kentdev/mMicroSD/schematic/v2.0/mMicroSD.pdf

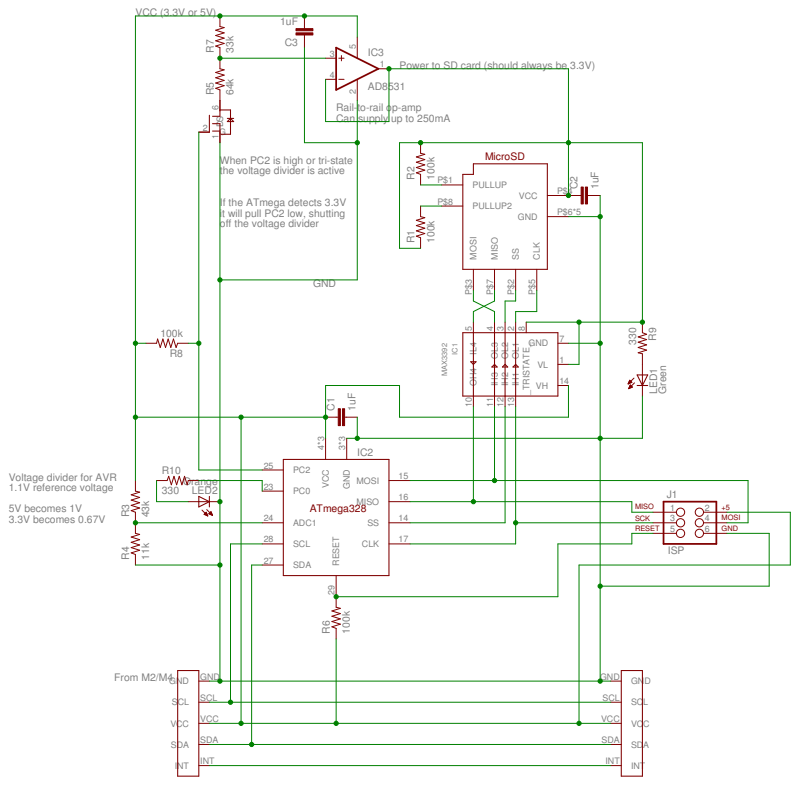
[picture p1: page 1]

Power to SD card (should always be 3.3V)
Rail-to-rail op-amp
Can supply up to 250mA

When PC2 is high or tri-state
the voltage divider is active

If the ATmega detects 3.3V
it will pull PC2 low, shutting
off the voltage divider

Voltage divider for AVR
1.1V reference voltage
5V becomes 1V
3.3V becomes 0.67V

VCC | | VCC

SDA | SDA
