kentdev/mMicroSD/schematic/v2.3/mMicroSD.brd

## EAGLE design schematic/v2.3/mMicroSD.brd (2015-05-24, an earlier design)

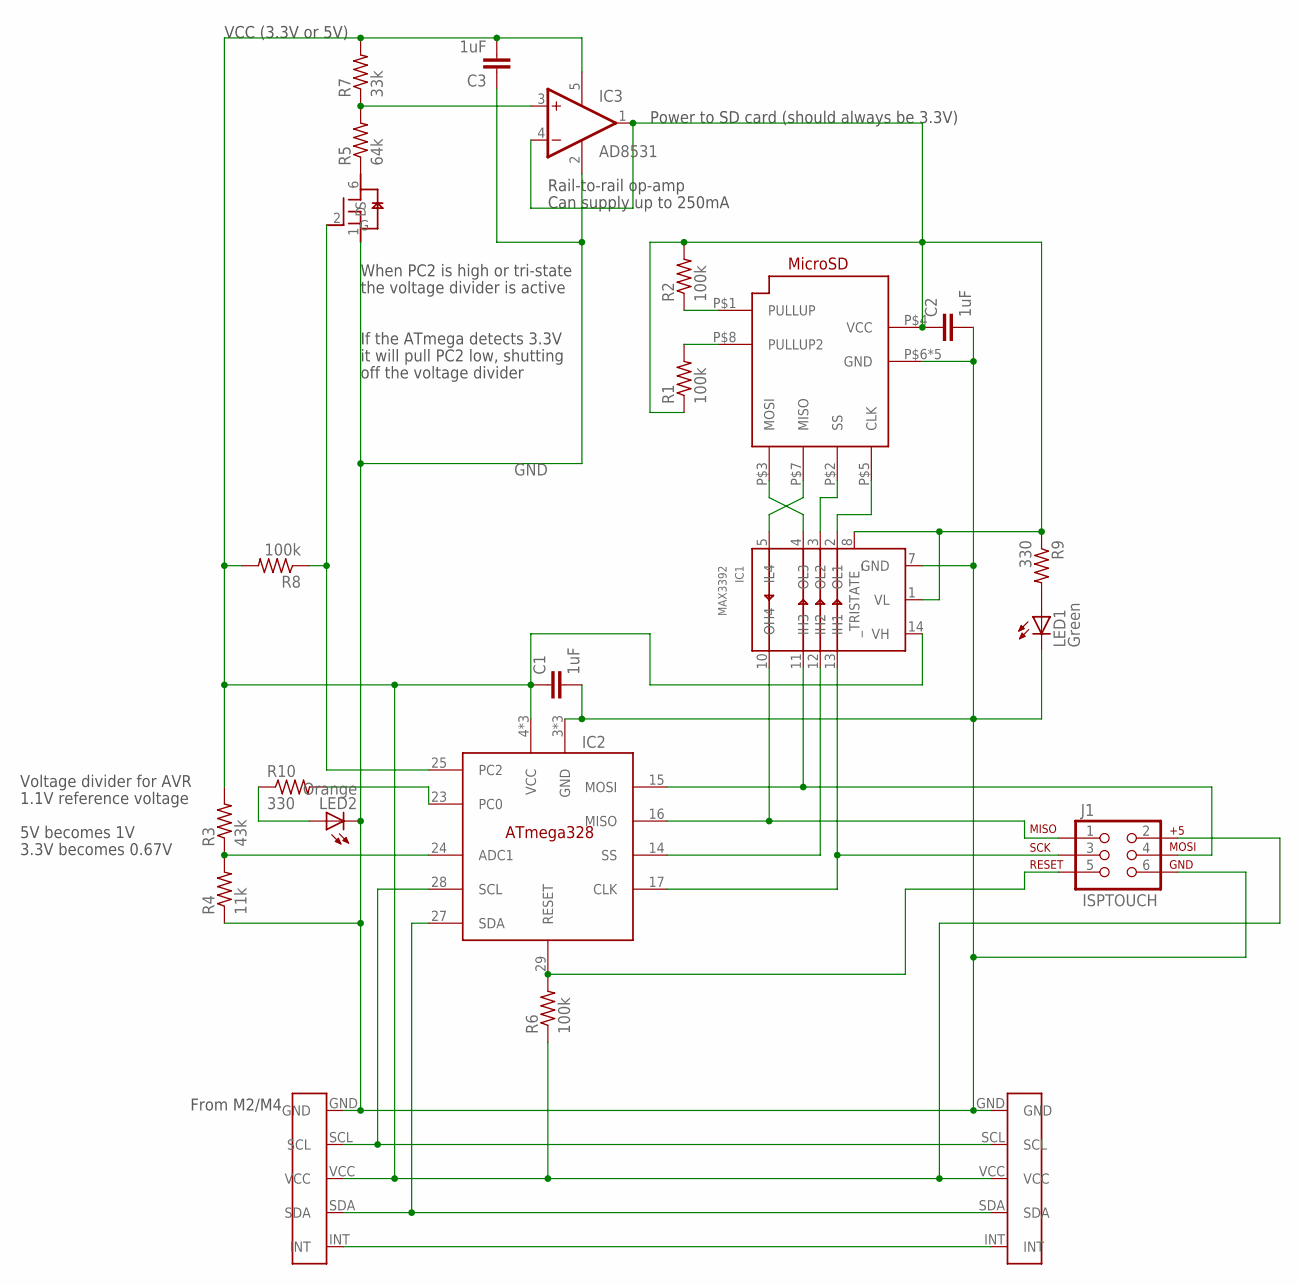
[picture p2: schematic mMicroSD.sch]

Parts:
C1, C2, C3: 1uF; C0603
IC1: MAX3392; 14-TSSOP
IC2: ATMEGA328
IC3: AD8531; SOT-23-5
J1: ISPTOUCH; AVX_9188_6-WAY_SMT
LED1: Green; SML0603
LED2: Orange; SML0603
M1: NTJD5121N; SOT-363
R1, R2, R6, R8: 100k; R0603
R3: 43k; R0603
R4: 11k; R0603
R5: 64k; R0603
R7: 33k; R0603
R9, R10: 330; R0603
SDCONN: 101-00660-68-6
U$1: MBUS_OUT
U$2: MBUS_IN

Connections:
ADC_LINE: IC2.24 (ADC1), R3.1, R4.2
DATA_LED: IC2.23 (PC0), R10.2
GATE: IC2.25 (PC2), M1.2 (G), R8.1
GND: C1.2, C2.2, C3.1, IC1.7 (GND), IC2.3 (GND), IC2.5 (GND), IC2.21 (GND), IC3.2 (V-), J1.6, LED1.C, LED2.C, M1.1 (S), R4.1, SDCONN.P$6 (GND), SDCONN.P$9 (GND), SDCONN.P$10 (GND), SDCONN.P$11 (GND), SDCONN.P$12 (GND), U$1.GND, U$2.GND
INT: U$1.INT, U$2.INT
MISO: IC1.10 (OH4), IC2.16 (MISO), J1.1
MOSI: IC1.11 (IH3), IC2.15 (MOSI), J1.4
unnamed: M1.6 (D), R5.1
unnamed: LED1.A, R9.2
unnamed: LED2.A, R10.1
unnamed: R1.2, SDCONN.P$8 (PULLUP2)
unnamed: R2.1, SDCONN.P$1 (PULLUP)
OPAMP_VOLTAGE: IC3.3 (+IN), R5.2, R7.1
RESET: IC2.29 (RESET), J1.5, R6.2
SCK: IC1.13 (IH1), IC2.17 (CLK), J1.3
SCL: IC2.28 (SCL), U$1.SCL, U$2.SCL
SDA: IC2.27 (SDA), U$1.SDA, U$2.SDA
SD_CS: IC1.3 (OL2), SDCONN.P$2 (SS)
SD_MISO: IC1.5 (IL4), SDCONN.P$7 (MISO)
SD_MOSI: IC1.4 (OL3), SDCONN.P$3 (MOSI)
SD_SCK: IC1.2 (OL1), SDCONN.P$5 (CLK)
SS: IC1.12 (IH2), IC2.14 (SS)
VCC_MBUS: C1.1, C3.2, IC1.14 (VH), IC2.4 (VCC), IC2.6 (VCC), IC2.18 (VCC), IC3.5 (V+), J1.2, R3.2, R6.1, R7.2, R8.2, U$1.VCC, U$2.VCC
VCC_SD: C2.1, IC1.1 (VL), IC1.8 (_TRISTATE_), IC3.1 (OUT), IC3.4 (-IN), R1.1, R2.2, R9.1, SDCONN.P$4 (VCC)

Notes on the sheet:
From M2/M4
VCC (3.3V or 5V)
Voltage divider for AVR
1.1V reference voltage
5V becomes 1V
3.3V becomes 0.67V
When PC2 is high or tri-state
the voltage divider is active
If the ATmega detects 3.3V
it will pull PC2 low, shutting
off the voltage divider
Power to SD card (should always be 3.3V)
Rail-to-rail op-amp
Can supply up to 250mA

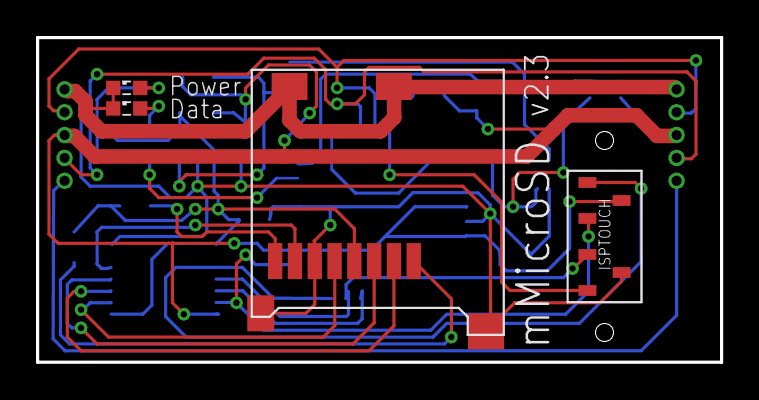
[picture p3: board schematic/v2.3/mMicroSD.brd from above]

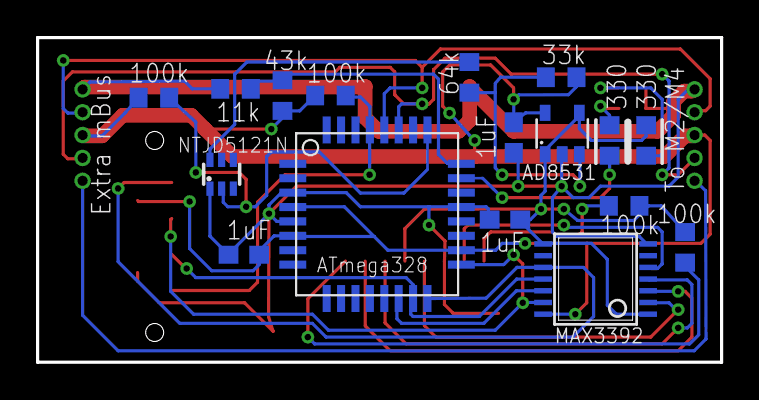
[picture p4: board schematic/v2.3/mMicroSD.brd from below]

Board: 2 copper layers, 38.0 x 18.0 mm, 23 parts (17 on the bottom side), 24 nets.
