kentdev/mMicroSD/schematic/v1.0/mMicroSD.brd

## EAGLE design schematic/v1.0/mMicroSD.brd (2014-10-27, an earlier design)

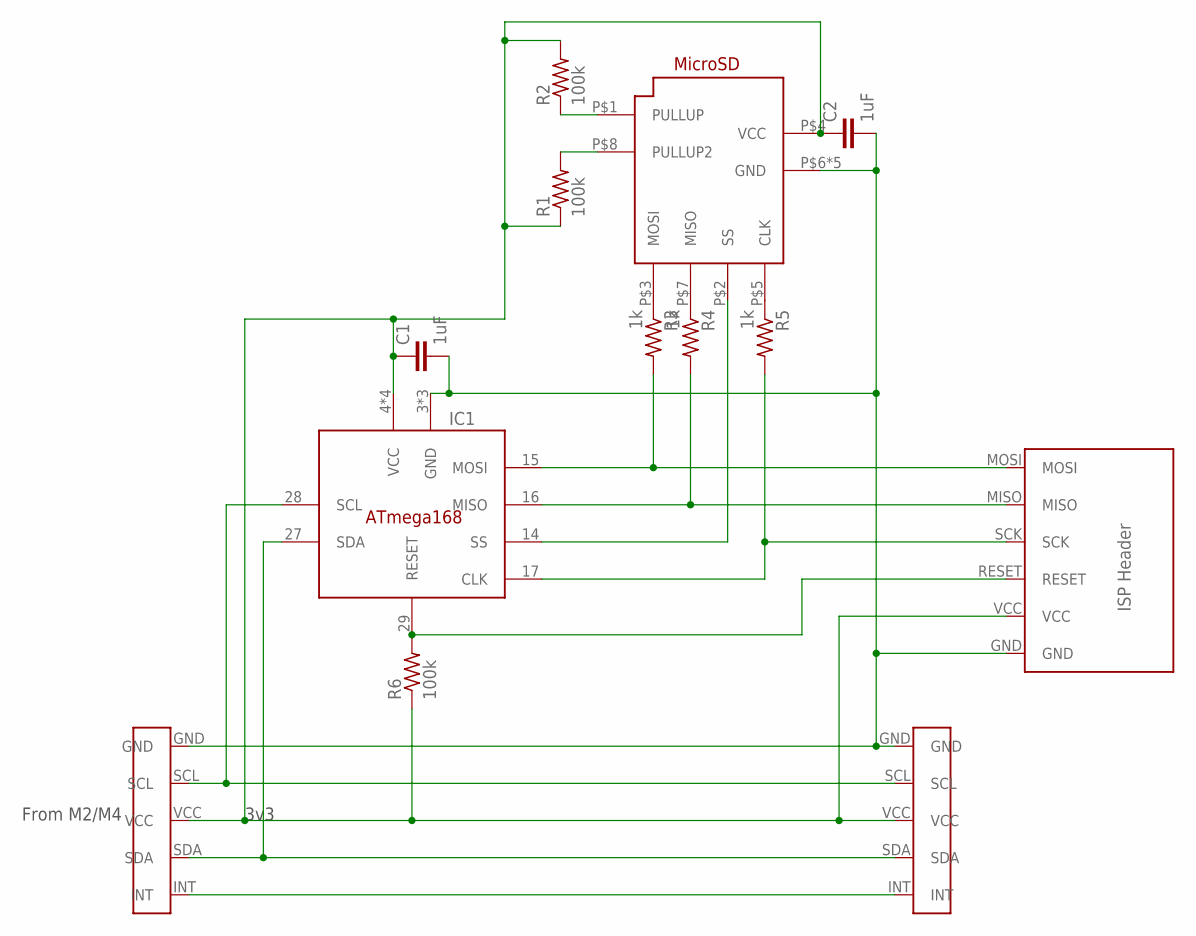
[picture p5: schematic mMicroSD.sch]

Parts:
C1, C2: 1uF; C0805
IC1: ATMEGA168
R1, R2, R6: 100k; R2012
R3, R4, R5: 1k; R2012
SDCONN: 101-00660-68-6
U$1: MBUS_OUT
U$2: MBUS_IN
U$3: ISP

Connections:
GND: C1.2, C2.2, IC1.3 (GND), IC1.5 (GND), IC1.21 (GND), SDCONN.P$6 (GND), SDCONN.P$9 (GND), SDCONN.P$10 (GND), SDCONN.P$11 (GND), SDCONN.P$12 (GND), U$1.GND, U$2.GND, U$3.GND
unnamed: U$1.INT, U$2.INT
unnamed: IC1.27 (SDA), U$1.SDA, U$2.SDA
unnamed: IC1.28 (SCL), U$1.SCL, U$2.SCL
unnamed: IC1.14 (SS), SDCONN.P$2 (SS)
unnamed: R3.1, SDCONN.P$3 (MOSI)
unnamed: R4.1, SDCONN.P$7 (MISO)
unnamed: IC1.16 (MISO), R4.2, U$3.MISO
unnamed: IC1.15 (MOSI), R3.2, U$3.MOSI
unnamed: IC1.29 (RESET), R6.2, U$3.RESET
unnamed: R1.2, SDCONN.P$8 (PULLUP2)
unnamed: R2.1, SDCONN.P$1 (PULLUP)
unnamed: IC1.17 (CLK), R5.2, U$3.SCK
unnamed: R5.1, SDCONN.P$5 (CLK)
VCC: C1.1, C2.1, IC1.4 (VCC), IC1.6 (VCC), IC1.18 (VCC), IC1.20 (VCC), R1.1, R2.2, R6.1, SDCONN.P$4 (VCC), U$1.VCC, U$2.VCC, U$3.VCC

Notes on the sheet:
3v3
From M2/M4

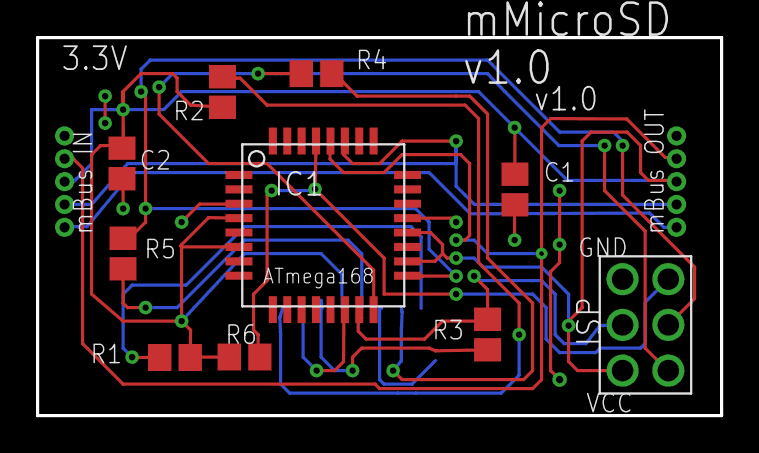
[picture p6: board schematic/v1.0/mMicroSD.brd from above]

Board: 2 copper layers, 38.0 x 21.0 mm, 13 parts (1 on the bottom side), 15 nets.
