kentdev/mMicroSD/code/m4_direct/mUSB.c

//-----------------------------------------------------------------------------
// MAEVARM M4 STM32F373 mUSB
// version: 1.0
// date: March 22, 2013
// author: Neel Shah (neels@seas.upenn.edu)
// Based on ST USB FS Driver LIbrary Example Virtual COM Port
//-----------------------------------------------------------------------------

#include "mUSB.h"

#define VCOMPORT_IN_FRAME_INTERVAL             5

__IO uint32_t bDeviceState = UNCONNECTED; /* USB device status */
__IO bool fSuspendEnabled = FALSE;  /* true when suspend is possible */
__IO uint32_t EP[8];
struct
{
  __IO RESUME_STATE eState;
  __IO uint8_t bESOFcnt;
}
ResumeS;
__IO uint32_t remotewakeupon=0;


__IO uint16_t wIstr;  /* ISTR register last read value */
__IO uint8_t bIntPackSOF = 0;  /* SOFs received between 2 consecutive packets */
__IO uint32_t esof_counter =0; /* expected SOF counter */
__IO uint32_t wCNTR=0;
ErrorStatus HSEStartUpStatus;
EXTI_InitTypeDef EXTI_InitStructure;
__IO uint8_t Send_Buffer[VIRTUAL_COM_PORT_DATA_SIZE] ;
uint32_t Receive_length;

extern __IO uint32_t packet_sent;
extern __IO uint32_t packet_receive;


uint8_t Request = 0;

LINE_CODING linecoding =
  {
    115200, /* baud rate*/
    0x00,   /* stop bits-1*/
    0x00,   /* parity - none*/
    0x08    /* no. of bits 8*/
  };

uint8_t Receive_Buffer[64];
uint32_t Send_length;



/*=========== Minimal System Call Implementation for newlib ===========*/

__IO uint32_t packet_sent=1;
__IO uint32_t packet_receive ;
char *__env[1] = { 0 };
char **environ = __env;

int _write(int file, char *ptr, int len)
{
  if(bDeviceState == CONFIGURED)
  {
    uint32_t timeout=180000;
    while((!packet_sent) && timeout--){}
    if(timeout)
    {
      uint8_t packetNo,finalPacket,i;
      packetNo    = len/64;
      finalPacket = len;
      for(i=0;i<packetNo;i++)
      {
        CDC_Send_DATA(ptr,63);
        finalPacket -= 63;
        ptr += 63;
        timeout=180000;
        while(packet_sent==0 && timeout--);
        if(timeout==0)
        { 
          bDeviceState = UNCONNECTED;
          return len;
        }
      }
      CDC_Send_DATA(ptr,finalPacket);
      return len;  
    }
    else 
    {
      return -1;
    }
  }
  else
  {
    return len;
  }

}


caddr_t _sbrk(int incr) 
{
  extern char _end; // Defined by the linker
  static char *heap_end;
  char *prev_heap_end;
  if(heap_end == 0) {heap_end = &_end;}
  prev_heap_end = heap_end;
  char * stack = (char*) __get_MSP();
  if (heap_end+incr >  stack)
    {
      _write(1, "Heap and stack collision\n", 25);
      return  (caddr_t) -1;
    }
  heap_end += incr;
  return (caddr_t) prev_heap_end;
}
int _read(int file, __IO char *ptr, int len) 
{
  CDC_Receive_DATA();
  ptr = Receive_Buffer;
  len = Receive_length;
  return len;
}
int _close(int file){return -1;}
int _fstat(int file, struct stat *st) {return 0;}
int _isatty(int file){return 1;}
int _lseek(int file, int ptr, int dir){return 0;}



/* USB Standard Device Descriptor */
const uint8_t Virtual_Com_Port_DeviceDescriptor[] =
  {
    0x12,   /* bLength */
    USB_DEVICE_DESCRIPTOR_TYPE,     /* bDescriptorType */
    0x00,
    0x02,   /* bcdUSB = 2.00 */
    0x02,   /* bDeviceClass: CDC */
    0x00,   /* bDeviceSubClass */
    0x00,   /* bDeviceProtocol */
    0x40,   /* bMaxPacketSize0 */
    0x83,
    0x04,   /* idVendor = 0x0483 */
    0x40,
    0x57,   /* idProduct = 0x7540 */
    0x00,
    0x02,   /* bcdDevice = 2.00 */
    1,              /* Index of string descriptor describing manufacturer */
    2,              /* Index of string descriptor describing product */
    3,              /* Index of string descriptor describing the device's serial number */
    0x01    /* bNumConfigurations */
  };

const uint8_t Virtual_Com_Port_ConfigDescriptor[] =
  {
    /*Configuration Descriptor*/
    0x09,   /* bLength: Configuration Descriptor size */
    USB_CONFIGURATION_DESCRIPTOR_TYPE,      /* bDescriptorType: Configuration */
    VIRTUAL_COM_PORT_SIZ_CONFIG_DESC,       /* wTotalLength:no of returned bytes */
    0x00,
    0x02,   /* bNumInterfaces: 2 interface */
    0x01,   /* bConfigurationValue: Configuration value */
    0x00,   /* iConfiguration: Index of string descriptor describing the configuration */
    0xC0,   /* bmAttributes: self powered */
    0x32,   /* MaxPower 0 mA */
    /*Interface Descriptor*/
    0x09,   /* bLength: Interface Descriptor size */
    USB_INTERFACE_DESCRIPTOR_TYPE,  /* bDescriptorType: Interface */
    /* Interface descriptor type */
    0x00,   /* bInterfaceNumber: Number of Interface */
    0x00,   /* bAlternateSetting: Alternate setting */
    0x01,   /* bNumEndpoints: One endpoints used */
    0x02,   /* bInterfaceClass: Communication Interface Class */
    0x02,   /* bInterfaceSubClass: Abstract Control Model */
    0x01,   /* bInterfaceProtocol: Common AT commands */
    0x00,   /* iInterface: */
    /*Header Functional Descriptor*/
    0x05,   /* bLength: Endpoint Descriptor size */
    0x24,   /* bDescriptorType: CS_INTERFACE */
    0x00,   /* bDescriptorSubtype: Header Func Desc */
    0x10,   /* bcdCDC: spec release number */
    0x01,
    /*Call Management Functional Descriptor*/
    0x05,   /* bFunctionLength */
    0x24,   /* bDescriptorType: CS_INTERFACE */
    0x01,   /* bDescriptorSubtype: Call Management Func Desc */
    0x00,   /* bmCapabilities: D0+D1 */
    0x01,   /* bDataInterface: 1 */
    /*ACM Functional Descriptor*/
    0x04,   /* bFunctionLength */
    0x24,   /* bDescriptorType: CS_INTERFACE */
    0x02,   /* bDescriptorSubtype: Abstract Control Management desc */
    0x02,   /* bmCapabilities */
    /*Union Functional Descriptor*/
    0x05,   /* bFunctionLength */
    0x24,   /* bDescriptorType: CS_INTERFACE */
    0x06,   /* bDescriptorSubtype: Union func desc */
    0x00,   /* bMasterInterface: Communication class interface */
    0x01,   /* bSlaveInterface0: Data Class Interface */
    /*Endpoint 2 Descriptor*/
    0x07,   /* bLength: Endpoint Descriptor size */
    USB_ENDPOINT_DESCRIPTOR_TYPE,   /* bDescriptorType: Endpoint */
    0x82,   /* bEndpointAddress: (IN2) */
    0x03,   /* bmAttributes: Interrupt */
    VIRTUAL_COM_PORT_INT_SIZE,      /* wMaxPacketSize: */
    0x00,
    0xFF,   /* bInterval: */
    /*Data class interface descriptor*/
    0x09,   /* bLength: Endpoint Descriptor size */
    USB_INTERFACE_DESCRIPTOR_TYPE,  /* bDescriptorType: */
    0x01,   /* bInterfaceNumber: Number of Interface */
    0x00,   /* bAlternateSetting: Alternate setting */
    0x02,   /* bNumEndpoints: Two endpoints used */
    0x0A,   /* bInterfaceClass: CDC */
    0x00,   /* bInterfaceSubClass: */
    0x00,   /* bInterfaceProtocol: */
    0x00,   /* iInterface: */
    /*Endpoint 3 Descriptor*/
    0x07,   /* bLength: Endpoint Descriptor size */
    USB_ENDPOINT_DESCRIPTOR_TYPE,   /* bDescriptorType: Endpoint */
    0x03,   /* bEndpointAddress: (OUT3) */
    0x02,   /* bmAttributes: Bulk */
    VIRTUAL_COM_PORT_DATA_SIZE,             /* wMaxPacketSize: */
    0x00,
    0x00,   /* bInterval: ignore for Bulk transfer */
    /*Endpoint 1 Descriptor*/
    0x07,   /* bLength: Endpoint Descriptor size */
    USB_ENDPOINT_DESCRIPTOR_TYPE,   /* bDescriptorType: Endpoint */
    0x81,   /* bEndpointAddress: (IN1) */
    0x02,   /* bmAttributes: Bulk */
    VIRTUAL_COM_PORT_DATA_SIZE,             /* wMaxPacketSize: */
    0x00,
    0x00    /* bInterval */
  };

/* USB String Descriptors */
const uint8_t Virtual_Com_Port_StringLangID[VIRTUAL_COM_PORT_SIZ_STRING_LANGID] =
  {
    VIRTUAL_COM_PORT_SIZ_STRING_LANGID,
    USB_STRING_DESCRIPTOR_TYPE,
    0x09,
    0x04 /* LangID = 0x0409: U.S. English */
  };

const uint8_t Virtual_Com_Port_StringVendor[VIRTUAL_COM_PORT_SIZ_STRING_VENDOR] =
  {
    VIRTUAL_COM_PORT_SIZ_STRING_VENDOR,     /* Size of Vendor string */
    USB_STRING_DESCRIPTOR_TYPE,             /* bDescriptorType*/
    /* Manufacturer: "STMicroelectronics" */
    'S', 0, 'T', 0, 'M', 0, 'i', 0, 'c', 0, 'r', 0, 'o', 0, 'e', 0,
    'l', 0, 'e', 0, 'c', 0, 't', 0, 'r', 0, 'o', 0, 'n', 0, 'i', 0,
    'c', 0, 's', 0
  };

const uint8_t Virtual_Com_Port_StringProduct[VIRTUAL_COM_PORT_SIZ_STRING_PRODUCT] =
  {
    VIRTUAL_COM_PORT_SIZ_STRING_PRODUCT,          /* bLength */
    USB_STRING_DESCRIPTOR_TYPE,        /* bDescriptorType */
    /* Product name: "STM32 Virtual COM Port" */
    'S', 0, 'T', 0, 'M', 0, '3', 0, '2', 0, ' ', 0, 'V', 0, 'i', 0,
    'r', 0, 't', 0, 'u', 0, 'a', 0, 'l', 0, ' ', 0, 'C', 0, 'O', 0,
    'M', 0, ' ', 0, 'P', 0, 'o', 0, 'r', 0, 't', 0, ' ', 0, ' ', 0
  };

uint8_t Virtual_Com_Port_StringSerial[VIRTUAL_COM_PORT_SIZ_STRING_SERIAL] =
  {
    VIRTUAL_COM_PORT_SIZ_STRING_SERIAL,           /* bLength */
    USB_STRING_DESCRIPTOR_TYPE,                   /* bDescriptorType */
    'S', 0, 'T', 0, 'M', 0, '3', 0, '2', 0
  };

RESULT PowerOn(void)
{
  uint16_t wRegVal;

  /*** cable plugged-in ? ***/
  USB_Cable_Config(ENABLE);

  /*** CNTR_PWDN = 0 ***/
  wRegVal = CNTR_FRES;
  _SetCNTR(wRegVal);

  /*** CNTR_FRES = 0 ***/
  wInterrupt_Mask = 0;
  _SetCNTR(wInterrupt_Mask);
  /*** Clear pending interrupts ***/
  _SetISTR(0);
  /*** Set interrupt mask ***/
  wInterrupt_Mask = CNTR_RESETM | CNTR_SUSPM | CNTR_WKUPM;
  _SetCNTR(wInterrupt_Mask);
  
  return USB_SUCCESS;
}
RESULT PowerOff()
{
  /* disable all interrupts and force USB reset */
  _SetCNTR(CNTR_FRES);
  /* clear interrupt status register */
  _SetISTR(0);
  /* Disable the Pull-Up*/
  USB_Cable_Config(DISABLE);
  /* switch-off device */
  _SetCNTR(CNTR_FRES + CNTR_PDWN);
  /* sw variables reset */
  /* ... */

  return USB_SUCCESS;
}
void Suspend(void)
{
	uint32_t i =0;
	uint16_t wCNTR;
	uint32_t tmpreg = 0;
  __IO uint32_t savePWR_CR=0;
	/* suspend preparation */
	/* ... */
	
	/*Store CNTR value */
	wCNTR = _GetCNTR();  

    /* This a sequence to apply a force RESET to handle a robustness case */
    
	/*Store endpoints registers status */
    for (i=0;i<8;i++) EP[i] = _GetENDPOINT(i);
	
	/* unmask RESET flag */
	wCNTR|=CNTR_RESETM;
	_SetCNTR(wCNTR);
	
	/*apply FRES */
	wCNTR|=CNTR_FRES;
	_SetCNTR(wCNTR);
	
	/*clear FRES*/
	wCNTR&=~CNTR_FRES;
	_SetCNTR(wCNTR);
	
	/*poll for RESET flag in ISTR*/
	while((_GetISTR()&ISTR_RESET) == 0);
	
	/* clear RESET flag in ISTR */
	_SetISTR((uint16_t)CLR_RESET);
	
	/*restore Enpoints*/
	for (i=0;i<8;i++)
	_SetENDPOINT(i, EP[i]);
	
	/* Now it is safe to enter macrocell in suspend mode */
	wCNTR |= CNTR_FSUSP;
	_SetCNTR(wCNTR);
	
	/* force low-power mode in the macrocell */
	wCNTR = _GetCNTR();
	wCNTR |= CNTR_LPMODE;
	_SetCNTR(wCNTR);
	
	/*prepare entry in low power mode (STOP mode)*/
	/* Select the regulator state in STOP mode*/
	savePWR_CR = PWR->CR;
	tmpreg = PWR->CR;
	/* Clear PDDS and LPDS bits */
	tmpreg &= ((uint32_t)0xFFFFFFFC);
	/* Set LPDS bit according to PWR_Regulator value */
	tmpreg |= PWR_Regulator_LowPower;
	/* Store the new value */
	PWR->CR = tmpreg;
	/* Set SLEEPDEEP bit of Cortex System Control Register */
        SCB->SCR |= SCB_SCR_SLEEPDEEP_Msk;
	/* enter system in STOP mode, only when wakeup flag in not set */
	if((_GetISTR()&ISTR_WKUP)==0)
	{
		__WFI();
		/* Reset SLEEPDEEP bit of Cortex System Control Register */
                SCB->SCR &= (uint32_t)~((uint32_t)SCB_SCR_SLEEPDEEP_Msk); 
	}
	else
	{
		/* Clear Wakeup flag */
		_SetISTR(CLR_WKUP);
		/* clear FSUSP to abort entry in suspend mode  */
        wCNTR = _GetCNTR();
        wCNTR&=~CNTR_FSUSP;
        _SetCNTR(wCNTR);
		
		/*restore sleep mode configuration */ 
		/* restore Power regulator config in sleep mode*/
		PWR->CR = savePWR_CR;
		
		/* Reset SLEEPDEEP bit of Cortex System Control Register */		
                SCB->SCR &= (uint32_t)~((uint32_t)SCB_SCR_SLEEPDEEP_Msk);
              
    }
}
void Resume_Init(void)
{
  uint16_t wCNTR;
  
  /* ------------------ ONLY WITH BUS-POWERED DEVICES ---------------------- */
  /* restart the clocks */
  /* ...  */

  /* CNTR_LPMODE = 0 */
  wCNTR = _GetCNTR();
  wCNTR &= (~CNTR_LPMODE);
  _SetCNTR(wCNTR);    
  
  /* restore full power */
  /* ... on connected devices */
  Leave_LowPowerMode();

  /* reset FSUSP bit */
  _SetCNTR(IMR_MSK);

  /* reverse suspend preparation */
  /* ... */ 

}
void Resume(RESUME_STATE eResumeSetVal)
{
  uint16_t wCNTR;

  if (eResumeSetVal != RESUME_ESOF)
    ResumeS.eState = eResumeSetVal;
  switch (ResumeS.eState)
  {
    case RESUME_EXTERNAL:
      if (remotewakeupon ==0)
      {
        Resume_Init();
        ResumeS.eState = RESUME_OFF;
      }
      else /* RESUME detected during the RemoteWAkeup signalling => keep RemoteWakeup handling*/
      {
        ResumeS.eState = RESUME_ON;
      }
      break;
    case RESUME_INTERNAL:
      Resume_Init();
      ResumeS.eState = RESUME_START;
      remotewakeupon = 1;
      break;
    case RESUME_LATER:
      ResumeS.bESOFcnt = 2;
      ResumeS.eState = RESUME_WAIT;
      break;
    case RESUME_WAIT:
      ResumeS.bESOFcnt--;
      if (ResumeS.bESOFcnt == 0)
        ResumeS.eState = RESUME_START;
      break;
    case RESUME_START:
      wCNTR = _GetCNTR();
      wCNTR |= CNTR_RESUME;
      _SetCNTR(wCNTR);
      ResumeS.eState = RESUME_ON;
      ResumeS.bESOFcnt = 10;
      break;
    case RESUME_ON:    
      ResumeS.bESOFcnt--;
      if (ResumeS.bESOFcnt == 0)
      {
        wCNTR = _GetCNTR();
        wCNTR &= (~CNTR_RESUME);
        _SetCNTR(wCNTR);
        ResumeS.eState = RESUME_OFF;
        remotewakeupon = 0;
      }
      break;
    case RESUME_OFF:
    case RESUME_ESOF:
    default:
      ResumeS.eState = RESUME_OFF;
      break;
  }
}

void (*pEpInt_IN[7])(void) =
  {
    EP1_IN_Callback,
    EP2_IN_Callback,
    EP3_IN_Callback,
    EP4_IN_Callback,
    EP5_IN_Callback,
    EP6_IN_Callback,
    EP7_IN_Callback,
  };

void (*pEpInt_OUT[7])(void) =
  {
    EP1_OUT_Callback,
    EP2_OUT_Callback,
    EP3_OUT_Callback,
    EP4_OUT_Callback,
    EP5_OUT_Callback,
    EP6_OUT_Callback,
    EP7_OUT_Callback,
  };

void USB_Istr(void)
{
    uint32_t i=0;
 __IO uint32_t EP[8];
  
  wIstr = _GetISTR();

#if (IMR_MSK & ISTR_SOF)
  if (wIstr & ISTR_SOF & wInterrupt_Mask)
  {
    _SetISTR((uint16_t)CLR_SOF);
    bIntPackSOF++;

#ifdef SOF_CALLBACK
    SOF_Callback();
#endif
  }
#endif
  /*-*-*-*-*-*-*-*-*-*-*-*-*-*-*-*-*-*-*-*-*-*-*-*-*-*-*-*-*-*-*-*-*-*-*/  
  
#if (IMR_MSK & ISTR_CTR)
  if (wIstr & ISTR_CTR & wInterrupt_Mask)
  {
    /* servicing of the endpoint correct transfer interrupt */
    /* clear of the CTR flag into the sub */
    CTR_LP();
#ifdef CTR_CALLBACK
    CTR_Callback();
#endif
  }
#endif
  /*-*-*-*-*-*-*-*-*-*-*-*-*-*-*-*-*-*-*-*-*-*-*-*-*-*-*-*-*-*-*-*-*-*-*/  
#if (IMR_MSK & ISTR_RESET)
  if (wIstr & ISTR_RESET & wInterrupt_Mask)
  {
    _SetISTR((uint16_t)CLR_RESET);
    Device_Property.Reset();
#ifdef RESET_CALLBACK
    RESET_Callback();
#endif
  }
#endif
  /*-*-*-*-*-*-*-*-*-*-*-*-*-*-*-*-*-*-*-*-*-*-*-*-*-*-*-*-*-*-*-*-*-*-*/
#if (IMR_MSK & ISTR_DOVR)
  if (wIstr & ISTR_DOVR & wInterrupt_Mask)
  {
    _SetISTR((uint16_t)CLR_DOVR);
#ifdef DOVR_CALLBACK
    DOVR_Callback();
#endif
  }
#endif
  /*-*-*-*-*-*-*-*-*-*-*-*-*-*-*-*-*-*-*-*-*-*-*-*-*-*-*-*-*-*-*-*-*-*-*/
#if (IMR_MSK & ISTR_ERR)
  if (wIstr & ISTR_ERR & wInterrupt_Mask)
  {
    _SetISTR((uint16_t)CLR_ERR);
#ifdef ERR_CALLBACK
    ERR_Callback();
#endif
  }
#endif
  /*-*-*-*-*-*-*-*-*-*-*-*-*-*-*-*-*-*-*-*-*-*-*-*-*-*-*-*-*-*-*-*-*-*-*/
#if (IMR_MSK & ISTR_WKUP)
  if (wIstr & ISTR_WKUP & wInterrupt_Mask)
  {
    _SetISTR((uint16_t)CLR_WKUP);
    Resume(RESUME_EXTERNAL);
#ifdef WKUP_CALLBACK
    WKUP_Callback();
#endif
  }
#endif
  /*-*-*-*-*-*-*-*-*-*-*-*-*-*-*-*-*-*-*-*-*-*-*-*-*-*-*-*-*-*-*-*-*-*-*/
#if (IMR_MSK & ISTR_SUSP)
  if (wIstr & ISTR_SUSP & wInterrupt_Mask)
  {

    /* check if SUSPEND is possible */
    if (fSuspendEnabled)
    {
      Suspend();
    }
    else
    {
      /* if not possible then resume after xx ms */
      Resume(RESUME_LATER);
    }
    /* clear of the ISTR bit must be done after setting of CNTR_FSUSP */
    _SetISTR((uint16_t)CLR_SUSP);
#ifdef SUSP_CALLBACK
    SUSP_Callback();
#endif
  }
#endif
  /*-*-*-*-*-*-*-*-*-*-*-*-*-*-*-*-*-*-*-*-*-*-*-*-*-*-*-*-*-*-*-*-*-*-*/

#if (IMR_MSK & ISTR_ESOF)
  if (wIstr & ISTR_ESOF & wInterrupt_Mask)
  {
    /* clear ESOF flag in ISTR */
    _SetISTR((uint16_t)CLR_ESOF);
    
    if ((_GetFNR()&FNR_RXDP)!=0)
    {
      /* increment ESOF counter */
      esof_counter ++;
      
      /* test if we enter in ESOF more than 3 times with FSUSP =0 and RXDP =1=>> possible missing SUSP flag*/
      if ((esof_counter >3)&&((_GetCNTR()&CNTR_FSUSP)==0))
      {           
        /* this a sequence to apply a force RESET*/
      
        /*Store CNTR value */
        wCNTR = _GetCNTR(); 
      
        /*Store endpoints registers status */
        for (i=0;i<8;i++) EP[i] = _GetENDPOINT(i);
      
        /*apply FRES */
        wCNTR|=CNTR_FRES;
        _SetCNTR(wCNTR);
 
        /*clear FRES*/
        wCNTR&=~CNTR_FRES;
        _SetCNTR(wCNTR);
      
        /*poll for RESET flag in ISTR*/
        while((_GetISTR()&ISTR_RESET) == 0);
        /* clear RESET flag in ISTR */
        _SetISTR((uint16_t)CLR_RESET);
   
       /*restore Enpoints*/
        for (i=0;i<8;i++)
        _SetENDPOINT(i, EP[i]);
      
        esof_counter = 0;
      }
    }
    else
    {
        esof_counter = 0;
    }
    
    /* resume handling timing is made with ESOFs */
    Resume(RESUME_ESOF); /* request without change of the machine state */

#ifdef ESOF_CALLBACK
    ESOF_Callback();
#endif
  }
#endif
} /* USB_Istr */


void EP1_IN_Callback (void)
{
  packet_sent = 1;
}
void EP3_OUT_Callback(void)
{
  packet_receive = 1;
  Receive_length = GetEPRxCount(ENDP3);
  PMAToUserBufferCopy((unsigned char*)Receive_Buffer, ENDP3_RXADDR, Receive_length);
}

/* -------------------------------------------------------------------------- */
/*  Structures initializations */
/* -------------------------------------------------------------------------- */

DEVICE Device_Table =
  {
    EP_NUM,
    1
  };

DEVICE_PROP Device_Property =
  {
    Virtual_Com_Port_init,
    Virtual_Com_Port_Reset,
    Virtual_Com_Port_Status_In,
    Virtual_Com_Port_Status_Out,
    Virtual_Com_Port_Data_Setup,
    Virtual_Com_Port_NoData_Setup,
    Virtual_Com_Port_Get_Interface_Setting,
    Virtual_Com_Port_GetDeviceDescriptor,
    Virtual_Com_Port_GetConfigDescriptor,
    Virtual_Com_Port_GetStringDescriptor,
    0,
    0x40 /*MAX PACKET SIZE*/
  };

USER_STANDARD_REQUESTS User_Standard_Requests =
  {
    Virtual_Com_Port_GetConfiguration,
    Virtual_Com_Port_SetConfiguration,
    Virtual_Com_Port_GetInterface,
    Virtual_Com_Port_SetInterface,
    Virtual_Com_Port_GetStatus,
    Virtual_Com_Port_ClearFeature,
    Virtual_Com_Port_SetEndPointFeature,
    Virtual_Com_Port_SetDeviceFeature,
    Virtual_Com_Port_SetDeviceAddress
  };

ONE_DESCRIPTOR Device_Descriptor =
  {
    (uint8_t*)Virtual_Com_Port_DeviceDescriptor,
    VIRTUAL_COM_PORT_SIZ_DEVICE_DESC
  };

ONE_DESCRIPTOR Config_Descriptor =
  {
    (uint8_t*)Virtual_Com_Port_ConfigDescriptor,
    VIRTUAL_COM_PORT_SIZ_CONFIG_DESC
  };

ONE_DESCRIPTOR String_Descriptor[4] =
  {
    {(uint8_t*)Virtual_Com_Port_StringLangID, VIRTUAL_COM_PORT_SIZ_STRING_LANGID},
    {(uint8_t*)Virtual_Com_Port_StringVendor, VIRTUAL_COM_PORT_SIZ_STRING_VENDOR},
    {(uint8_t*)Virtual_Com_Port_StringProduct, VIRTUAL_COM_PORT_SIZ_STRING_PRODUCT},
    {(uint8_t*)Virtual_Com_Port_StringSerial, VIRTUAL_COM_PORT_SIZ_STRING_SERIAL}
  };
void Virtual_Com_Port_init(void)
{
	Get_SerialNum();

  pInformation->Current_Configuration = 0;

  /* Connect the device */
  PowerOn();

  /* Perform basic device initialization operations */
  USB_SIL_Init();

  bDeviceState = UNCONNECTED;
}

void Virtual_Com_Port_Reset(void)
{
  /* Set Virtual_Com_Port DEVICE as not configured */
  pInformation->Current_Configuration = 0;

  /* Current Feature initialization */
  pInformation->Current_Feature = Virtual_Com_Port_ConfigDescriptor[7];

  /* Set Virtual_Com_Port DEVICE with the default Interface*/
  pInformation->Current_Interface = 0;

  SetBTABLE(BTABLE_ADDRESS);

  /* Initialize Endpoint 0 */
  SetEPType(ENDP0, EP_CONTROL);
  SetEPTxStatus(ENDP0, EP_TX_STALL);
  SetEPRxAddr(ENDP0, ENDP0_RXADDR);
  SetEPTxAddr(ENDP0, ENDP0_TXADDR);
  Clear_Status_Out(ENDP0);
  SetEPRxCount(ENDP0, Device_Property.MaxPacketSize);
  SetEPRxValid(ENDP0);

  /* Initialize Endpoint 1 */
  SetEPType(ENDP1, EP_BULK);
  SetEPTxAddr(ENDP1, ENDP1_TXADDR);
  SetEPTxStatus(ENDP1, EP_TX_NAK);
  SetEPRxStatus(ENDP1, EP_RX_DIS);

  /* Initialize Endpoint 2 */
  SetEPType(ENDP2, EP_INTERRUPT);
  SetEPTxAddr(ENDP2, ENDP2_TXADDR);
  SetEPRxStatus(ENDP2, EP_RX_DIS);
  SetEPTxStatus(ENDP2, EP_TX_NAK);

  /* Initialize Endpoint 3 */
  SetEPType(ENDP3, EP_BULK);
  SetEPRxAddr(ENDP3, ENDP3_RXADDR);
  SetEPRxCount(ENDP3, VIRTUAL_COM_PORT_DATA_SIZE);
  SetEPRxStatus(ENDP3, EP_RX_VALID);
  SetEPTxStatus(ENDP3, EP_TX_DIS);

  /* Set this device to response on default address */
  SetDeviceAddress(0);
  
  bDeviceState = ATTACHED;
}
void Virtual_Com_Port_SetConfiguration(void)
{
  DEVICE_INFO *pInfo = &Device_Info;

  if (pInfo->Current_Configuration != 0)
  {
    /* Device configured */
    bDeviceState = CONFIGURED;
  }
}
void Virtual_Com_Port_SetDeviceAddress (void)
{
  bDeviceState = ADDRESSED;
}
void Virtual_Com_Port_Status_In(void)
{
  if (Request == SET_LINE_CODING)
  {
    Request = 0;
  }
}
void Virtual_Com_Port_Status_Out(void)
{}
RESULT Virtual_Com_Port_Data_Setup(uint8_t RequestNo)
{
  uint8_t    *(*CopyRoutine)(uint16_t);

  CopyRoutine = NULL;

  if (RequestNo == GET_LINE_CODING)
  {
    if (Type_Recipient == (CLASS_REQUEST | INTERFACE_RECIPIENT))
    {
      CopyRoutine = Virtual_Com_Port_GetLineCoding;
    }
  }
  else if (RequestNo == SET_LINE_CODING)
  {
    if (Type_Recipient == (CLASS_REQUEST | INTERFACE_RECIPIENT))
    {
      CopyRoutine = Virtual_Com_Port_SetLineCoding;
    }
    Request = SET_LINE_CODING;
  }

  if (CopyRoutine == NULL)
  {
    return USB_UNSUPPORT;
  }

  pInformation->Ctrl_Info.CopyData = CopyRoutine;
  pInformation->Ctrl_Info.Usb_wOffset = 0;
  (*CopyRoutine)(0);
  return USB_SUCCESS;
}
RESULT Virtual_Com_Port_NoData_Setup(uint8_t RequestNo)
{

  if (Type_Recipient == (CLASS_REQUEST | INTERFACE_RECIPIENT))
  {
    if (RequestNo == SET_COMM_FEATURE)
    {
      return USB_SUCCESS;
    }
    else if (RequestNo == SET_CONTROL_LINE_STATE)
    {
      return USB_SUCCESS;
    }
  }

  return USB_UNSUPPORT;
}
uint8_t *Virtual_Com_Port_GetDeviceDescriptor(uint16_t Length)
{
  return Standard_GetDescriptorData(Length, &Device_Descriptor);
}
uint8_t *Virtual_Com_Port_GetConfigDescriptor(uint16_t Length)
{
  return Standard_GetDescriptorData(Length, &Config_Descriptor);
}
uint8_t *Virtual_Com_Port_GetStringDescriptor(uint16_t Length)
{
  uint8_t wValue0 = pInformation->USBwValue0;
  if (wValue0 > 4)
  {
    return NULL;
  }
  else
  {
    return Standard_GetDescriptorData(Length, &String_Descriptor[wValue0]);
  }
}
RESULT Virtual_Com_Port_Get_Interface_Setting(uint8_t Interface, uint8_t AlternateSetting)
{
  if (AlternateSetting > 0)
  {
    return USB_UNSUPPORT;
  }
  else if (Interface > 1)
  {
    return USB_UNSUPPORT;
  }
  return USB_SUCCESS;
}
uint8_t *Virtual_Com_Port_GetLineCoding(uint16_t Length)
{
  if (Length == 0)
  {
    pInformation->Ctrl_Info.Usb_wLength = sizeof(linecoding);
    return NULL;
  }
  return(uint8_t *)&linecoding;
}
uint8_t *Virtual_Com_Port_SetLineCoding(uint16_t Length)
{
  if (Length == 0)
  {
    pInformation->Ctrl_Info.Usb_wLength = sizeof(linecoding);
    return NULL;
  }
  return(uint8_t *)&linecoding;
}


static void IntToUnicode (uint32_t value , uint8_t *pbuf , uint8_t len);


void mUSBInit(void)
{
  GPIO_InitTypeDef  GPIO_InitStructure;  
  
  /*Set PA11,12 as IN - USB_DM,DP*/ 
  GPIO_InitStructure.GPIO_Pin = GPIO_Pin_11 | GPIO_Pin_12;
  GPIO_InitStructure.GPIO_Speed = GPIO_Speed_50MHz;
  GPIO_InitStructure.GPIO_Mode = GPIO_Mode_AF;
  GPIO_InitStructure.GPIO_OType = GPIO_OType_PP;
  GPIO_InitStructure.GPIO_PuPd = GPIO_PuPd_NOPULL;
  GPIO_Init(GPIOA, &GPIO_InitStructure);
  
  /*SET PA11,12 for USB: USB_DM,DP*/
  GPIO_PinAFConfig(GPIOA, GPIO_PinSource11, GPIO_AF_14);
  GPIO_PinAFConfig(GPIOA, GPIO_PinSource12, GPIO_AF_14);
  
  /* USB_DISCONNECT used as USB pull-up */
  GPIO_InitStructure.GPIO_Pin = USB_DISCONNECT_PIN;
  GPIO_InitStructure.GPIO_Speed = GPIO_Speed_2MHz;
  GPIO_InitStructure.GPIO_Mode = GPIO_Mode_OUT;
  GPIO_InitStructure.GPIO_OType = GPIO_OType_OD;
  GPIO_InitStructure.GPIO_PuPd = GPIO_PuPd_NOPULL;
  GPIO_Init(USB_DISCONNECT, &GPIO_InitStructure);
 
   /* Configure the EXTI line 18 connected internally to the USB IP */
  EXTI_ClearITPendingBit(EXTI_Line18);
  EXTI_InitStructure.EXTI_Line = EXTI_Line18;
  EXTI_InitStructure.EXTI_Trigger = EXTI_Trigger_Rising;
  EXTI_InitStructure.EXTI_LineCmd = ENABLE;
  EXTI_Init(&EXTI_InitStructure); 

  RCC_USBCLKConfig(RCC_USBCLKSource_PLLCLK_1Div5);
  RCC_APB1PeriphClockCmd(RCC_APB1Periph_USB, ENABLE);

  NVIC_InitTypeDef NVIC_InitStructure;

  /* 2 bit for pre-emption priority, 2 bits for subpriority */
  NVIC_PriorityGroupConfig(NVIC_PriorityGroup_2);
 
  /* Enable the USB interrupt */
  NVIC_InitStructure.NVIC_IRQChannel = USB_LP_IRQn;
  NVIC_InitStructure.NVIC_IRQChannelPreemptionPriority = 2;
  NVIC_InitStructure.NVIC_IRQChannelSubPriority = 0;
  NVIC_InitStructure.NVIC_IRQChannelCmd = ENABLE;
  NVIC_Init(&NVIC_InitStructure);
  
  /* Enable the USB Wake-up interrupt */
  NVIC_InitStructure.NVIC_IRQChannel = USBWakeUp_IRQn;
  NVIC_InitStructure.NVIC_IRQChannelPreemptionPriority = 1;
  NVIC_InitStructure.NVIC_IRQChannelCmd = ENABLE;
  NVIC_Init(&NVIC_InitStructure);

  setvbuf(stdout, (char *)0, _IOLBF, 256);
  setvbuf(stdin , (char *)0, _IOLBF, 256);
  setvbuf(stderr, (char *)0, _IOLBF, 256);

  USB_Init();

}
void Enter_LowPowerMode(void)
{
  bDeviceState = SUSPENDED;
}
void Leave_LowPowerMode(void)
{
  DEVICE_INFO *pInfo = &Device_Info;
  /* Set the device state to the correct state */
  if (pInfo->Current_Configuration != 0)
  {
    /* Device configured */
    bDeviceState = CONFIGURED;
  }
  else
  {
    bDeviceState = ATTACHED;
  }
  SystemInit();
}
void USB_Cable_Config (FunctionalState NewState)
{
  if (NewState != DISABLE)
    GPIO_ResetBits(USB_DISCONNECT, USB_DISCONNECT_PIN);
  else
    GPIO_SetBits(USB_DISCONNECT, USB_DISCONNECT_PIN);
}
void Get_SerialNum(void)
{
  uint32_t Device_Serial0, Device_Serial1, Device_Serial2;
  Device_Serial0 = *(uint32_t*)ID1;
  Device_Serial1 = *(uint32_t*)ID2;
  Device_Serial2 = *(uint32_t*)ID3;
  Device_Serial0 += Device_Serial2;
  if (Device_Serial0 != 0)
  {
    IntToUnicode (Device_Serial0, &Virtual_Com_Port_StringSerial[2] , 8);
    IntToUnicode (Device_Serial1, &Virtual_Com_Port_StringSerial[18], 4);
  }
}
static void IntToUnicode (uint32_t value , uint8_t *pbuf , uint8_t len)
{
  uint8_t idx = 0;  
  for( idx = 0 ; idx < len ; idx ++)
  {
    if( ((value >> 28)) < 0xA )
    {
      pbuf[ 2* idx] = (value >> 28) + '0';
    }
    else
    {
      pbuf[2* idx] = (value >> 28) + 'A' - 10; 
    }
    value = value << 4;
    pbuf[ 2* idx + 1] = 0;
  }
}
uint32_t CDC_Send_DATA (uint8_t *ptrBuffer, uint8_t Send_length)
{
  if(Send_length < VIRTUAL_COM_PORT_DATA_SIZE)     
  {
    /*Sent flag*/
    packet_sent = 0;
    /* send  packet to PMA*/
    UserToPMABufferCopy((unsigned char*)ptrBuffer, ENDP1_TXADDR, Send_length);
    SetEPTxCount(ENDP1, Send_length);
    SetEPTxValid(ENDP1);
  }
  else
  {
    return 0;
  } 
  return 1;
}
uint32_t CDC_Receive_DATA(void)
{ 
  /*Receive flag*/
  packet_receive = 0;
  SetEPRxValid(ENDP3); 
  return 1 ;
}
