kentdev/mMicroSD/code/m4_direct/mUSB.h

//-----------------------------------------------------------------------------
// MAEVARM M4 STM32F373 mUSB 
// version: 1.0
// date: March 22, 2013
// author: Neel Shah (neels@seas.upenn.edu)
// Based on ST USB FS Driver LIbrary Example Virtual COM Port
//-----------------------------------------------------------------------------

#ifndef __m_usb
#define __m_usb
#include "mGeneral.h"
#include "usb_lib.h" 
#include <sys/stat.h> 

#define USB_DEVICE_DESCRIPTOR_TYPE              0x01
#define USB_CONFIGURATION_DESCRIPTOR_TYPE       0x02
#define USB_STRING_DESCRIPTOR_TYPE              0x03
#define USB_INTERFACE_DESCRIPTOR_TYPE           0x04
#define USB_ENDPOINT_DESCRIPTOR_TYPE            0x05

#define VIRTUAL_COM_PORT_DATA_SIZE              64
#define VIRTUAL_COM_PORT_INT_SIZE               8

#define VIRTUAL_COM_PORT_SIZ_DEVICE_DESC        18
#define VIRTUAL_COM_PORT_SIZ_CONFIG_DESC        67
#define VIRTUAL_COM_PORT_SIZ_STRING_LANGID      4
#define VIRTUAL_COM_PORT_SIZ_STRING_VENDOR      38
#define VIRTUAL_COM_PORT_SIZ_STRING_PRODUCT     50
#define VIRTUAL_COM_PORT_SIZ_STRING_SERIAL      26

#define STANDARD_ENDPOINT_DESC_SIZE             0x09


//USB conf
#define EP_NUM                          (4)

#define BTABLE_ADDRESS      (0x00)
#define ENDP0_RXADDR        (0x40)
#define ENDP0_TXADDR        (0x80)
#define ENDP1_TXADDR        (0xC0)
#define ENDP2_TXADDR        (0x100)
#define ENDP3_RXADDR        (0x110)
/*-------------------------------------------------------------*/
/* -------------------   ISTR events  -------------------------*/
/*-------------------------------------------------------------*/
/* IMR_MSK */
/* mask defining which events has to be handled */
/* by the device application software */
#define IMR_MSK (CNTR_CTRM  | CNTR_WKUPM | CNTR_SUSPM | CNTR_ERRM \
 				| CNTR_SOFM | CNTR_ESOFM | CNTR_RESETM )
/*#define CTR_CALLBACK*/
/*#define DOVR_CALLBACK*/
/*#define ERR_CALLBACK*/
/*#define WKUP_CALLBACK*/
/*#define SUSP_CALLBACK*/
/*#define RESET_CALLBACK*/
/*#define SOF_CALLBACK*/
/*#define ESOF_CALLBACK*/
/* CTR service routines */
/* associated to defined endpoints */
/*#define  EP1_IN_Callback   NOP_Process*/
#define  EP2_IN_Callback   NOP_Process
#define  EP3_IN_Callback   NOP_Process
#define  EP4_IN_Callback   NOP_Process
#define  EP5_IN_Callback   NOP_Process
#define  EP6_IN_Callback   NOP_Process
#define  EP7_IN_Callback   NOP_Process

#define  EP1_OUT_Callback   NOP_Process
#define  EP2_OUT_Callback   NOP_Process
/*#define  EP3_OUT_Callback   NOP_Process*/
#define  EP4_OUT_Callback   NOP_Process
#define  EP5_OUT_Callback   NOP_Process
#define  EP6_OUT_Callback   NOP_Process
#define  EP7_OUT_Callback   NOP_Process

//usb pwr
typedef enum _RESUME_STATE
{
  RESUME_EXTERNAL,
  RESUME_INTERNAL,
  RESUME_LATER,
  RESUME_WAIT,
  RESUME_START,
  RESUME_ON,
  RESUME_OFF,
  RESUME_ESOF
} RESUME_STATE;

typedef enum _DEVICE_STATE
{
  UNCONNECTED,
  ATTACHED,
  POWERED,
  SUSPENDED,
  ADDRESSED,
  CONFIGURED
} DEVICE_STATE;

/* External variables --------------------------------------------------------*/
extern  __IO uint32_t bDeviceState; /* USB device status */
extern __IO bool fSuspendEnabled;  /* true when suspend is possible */


/* Exported functions ------------------------------------------------------- */
extern const uint8_t Virtual_Com_Port_DeviceDescriptor[VIRTUAL_COM_PORT_SIZ_DEVICE_DESC];
extern const uint8_t Virtual_Com_Port_ConfigDescriptor[VIRTUAL_COM_PORT_SIZ_CONFIG_DESC];

extern const uint8_t Virtual_Com_Port_StringLangID[VIRTUAL_COM_PORT_SIZ_STRING_LANGID];
extern const uint8_t Virtual_Com_Port_StringVendor[VIRTUAL_COM_PORT_SIZ_STRING_VENDOR];
extern const uint8_t Virtual_Com_Port_StringProduct[VIRTUAL_COM_PORT_SIZ_STRING_PRODUCT];
extern uint8_t Virtual_Com_Port_StringSerial[VIRTUAL_COM_PORT_SIZ_STRING_SERIAL];

void Suspend(void);
void Resume_Init(void);
void Resume(RESUME_STATE eResumeSetVal);
RESULT PowerOn(void);
RESULT PowerOff(void);


typedef struct
{
  uint32_t bitrate;
  uint8_t format;
  uint8_t paritytype;
  uint8_t datatype;
}LINE_CODING;

/* Exported constants --------------------------------------------------------*/
/* Exported macro ------------------------------------------------------------*/
/* Exported define -----------------------------------------------------------*/

#define Virtual_Com_Port_GetConfiguration          NOP_Process
//#define Virtual_Com_Port_SetConfiguration          NOP_Process
#define Virtual_Com_Port_GetInterface              NOP_Process
#define Virtual_Com_Port_SetInterface              NOP_Process
#define Virtual_Com_Port_GetStatus                 NOP_Process
#define Virtual_Com_Port_ClearFeature              NOP_Process
#define Virtual_Com_Port_SetEndPointFeature        NOP_Process
#define Virtual_Com_Port_SetDeviceFeature          NOP_Process
//#define Virtual_Com_Port_SetDeviceAddress          NOP_Process

#define SEND_ENCAPSULATED_COMMAND   0x00
#define GET_ENCAPSULATED_RESPONSE   0x01
#define SET_COMM_FEATURE            0x02
#define GET_COMM_FEATURE            0x03
#define CLEAR_COMM_FEATURE          0x04
#define SET_LINE_CODING             0x20
#define GET_LINE_CODING             0x21
#define SET_CONTROL_LINE_STATE      0x22
#define SEND_BREAK                  0x23

/* Exported functions ------------------------------------------------------- */
void Virtual_Com_Port_init(void);
void Virtual_Com_Port_Reset(void);
void Virtual_Com_Port_SetConfiguration(void);
void Virtual_Com_Port_SetDeviceAddress (void);
void Virtual_Com_Port_Status_In (void);
void Virtual_Com_Port_Status_Out (void);
RESULT Virtual_Com_Port_Data_Setup(uint8_t);
RESULT Virtual_Com_Port_NoData_Setup(uint8_t);
RESULT Virtual_Com_Port_Get_Interface_Setting(uint8_t Interface, uint8_t AlternateSetting);
uint8_t *Virtual_Com_Port_GetDeviceDescriptor(uint16_t );
uint8_t *Virtual_Com_Port_GetConfigDescriptor(uint16_t);
uint8_t *Virtual_Com_Port_GetStringDescriptor(uint16_t);

uint8_t *Virtual_Com_Port_GetLineCoding(uint16_t Length);
uint8_t *Virtual_Com_Port_SetLineCoding(uint16_t Length);


//usb istr
void USB_Istr(void);

/* function prototypes Automatically built defining related macros */

void EP1_IN_Callback(void);
void EP2_IN_Callback(void);
void EP3_IN_Callback(void);
void EP4_IN_Callback(void);
void EP5_IN_Callback(void);
void EP6_IN_Callback(void);
void EP7_IN_Callback(void);

void EP1_OUT_Callback(void);
void EP2_OUT_Callback(void);
void EP3_OUT_Callback(void);
void EP4_OUT_Callback(void);
void EP5_OUT_Callback(void);
void EP6_OUT_Callback(void);
void EP7_OUT_Callback(void);

#ifdef CTR_CALLBACK
void CTR_Callback(void);
#endif

#ifdef DOVR_CALLBACK
void DOVR_Callback(void);
#endif

#ifdef ERR_CALLBACK
void ERR_Callback(void);
#endif

#ifdef WKUP_CALLBACK
void WKUP_Callback(void);
#endif

#ifdef SUSP_CALLBACK
void SUSP_Callback(void);
#endif

#ifdef RESET_CALLBACK
void RESET_Callback(void);
#endif

#ifdef SOF_CALLBACK
void SOF_Callback(void);
#endif

#ifdef ESOF_CALLBACK
void ESOF_Callback(void);
#endif

#define ID1 (0x1FFFF7AC)
#define ID2 (0x1FFFF7B0)
#define ID3 (0x1FFFF7B4)
#define USB_DISCONNECT                GPIOF 
#define USB_DISCONNECT_PIN            GPIO_Pin_2
#define RCC_AHBPeriph_GPIO_DISCONNECT RCC_AHBPeriph_GPIOF
#define MASS_MEMORY_START     0x04002000
#define BULK_MAX_PACKET_SIZE  0x00000040
#define LED_ON                0xF0
#define LED_OFF               0xFF

void mUSBInit(void);
void Enter_LowPowerMode(void);
void Leave_LowPowerMode(void);
void USB_Cable_Config(FunctionalState NewState);
void Get_SerialNum(void);
uint32_t CDC_Send_DATA (uint8_t *ptrBuffer, uint8_t Send_length);
uint32_t CDC_Receive_DATA(void);

#endif
