kentdev/mMicroSD/(commit log)

2014-12-19 Fixed length issues in filesystem characters vs normal file names
    [m_microsd.c, sd_fat32.c, sd_fat32.h, sd_highlevel.h]
2014-12-28 Renamed the mMicroSD directory to 'code', so now we have 'code' and 'schematic' instead of 'mMicroSD' and 'schematic'
2014-12-28 Added a new version of the mMicroSD board, now with programming pin guides that won't collide with the microSD card holder
    [mMicroSD.brd, mMicroSD.sch]
2015-02-02 Created new mMicroSD board layout, to give enough space for the ISPtouch programming adapter and to reduce the board size to match the M2 and M4 widths
    [mMicroSD.brd, mMicroSD.sch]
2015-02-02 Moved a few value labels around for better readability
    [mMicroSD.brd]
2015-02-19 Moved cap label a bit
    [mMicroSD.brd]
2015-03-01 Added some silkscreen to the board to make the orientation of two close resistors more apparent
    [mMicroSD.brd, mMicroSD.sch]
2015-03-01 Another small silkscreen change
    [mMicroSD.brd]
2015-03-03 Fixed a couple traces that had been disconnected accidentally while debugging
    [mMicroSD.brd]
2015-04-04 Fixed a bug in finding the first FAT32 sector (the number of hidden sectors doesn't matter
    [sd_fat32.c, sd_fat32.h]
2015-04-04 Added fuses to the makefile
2015-05-24 Created new (WIP) version of the board, with a pull-up resistor on the SD card's MISO line
    [mMicroSD.brd, mMicroSD.sch]
2015-05-24 Gave names to some previously anonymous lines
    [mMicroSD.brd, mMicroSD.sch]
