kentdev/mMicroSD/(notices)

Notices in the files:
code/common/crc.c:
Copyright 2001-2010 Georges Menie (www.menie.org)
All rights reserved.
